dk-1983/Haier-ESP32-Modbus/bench/README_RU.md

[English](README.md) | [Русский](README_RU.md)

# Haier hOn: Arduino Nano bench simulator 0.1.1

Имитатор ответов кондиционера для проверки **обычной прошивки ESP32-S3** и двух оптических каналов на столе. Реальный кондиционер полностью отключён от стенда. Независимый тестовый инструмент, не заводская прошивка и не полная модель поведения Haier.

## Подключение

Подтверждённая плата: классическая **Nano ATmega328P, 5 В**. На ESP остаётся основная прошивка проекта, GPIO17 TX / GPIO18 RX, 9600 8N1, без инверсии.

На Nano выбран SoftwareSerial: **D10 RX, D11 TX, 9600 8N1**. Аппаратный UART D0/D1 оставлен для USB-диагностики 115200; это исключает соединение выходов USB-UART адаптера и оптопары на RX0. На стороне ESP испытывается именно аппаратный UART полной прошивки, а не отдельный loopback-тест.

Используем два независимых канала из [схемы](../docs/PC817-UART-BENCH_RU.md), PC817 или проверенные по распиновке NEC PS2561-1:

| Соединение | На стенде |
|---|---|
| U1 анод, вывод 1 | +5 В Nano через 680 Ом |
| U1 катод, вывод 2 | Nano **D11 TX** |
| U1 коллектор, вывод 4 | ESP **GPIO18 RX**, подтяжка 2,2 кОм к **3,3 В ESP** |
| U1 эмиттер, вывод 3 | GND ESP |
| U2 анод, вывод 1 | +3,3 В ESP через 390 Ом |
| U2 катод, вывод 2 | ESP **GPIO17 TX** |
| U2 коллектор, вывод 4 | Nano **D10 RX**, подтяжка 4,7 кОм к **5 В Nano** |
| U2 эмиттер, вывод 3 | GND Nano |

Оба канала неинвертирующие. Никаких прямых перемычек TX-RX в обход оптопар; старый делитель/стабилитрон не подключать параллельно выходу U1. Пины 5 В, 3,3 В и TX — разные электрические цепи.

Nano питается от USB, ESP — от своего подходящего источника/программатора. **Не питать ESP от выхода 3,3 В Nano.** Не соединять выходы разных источников питания друг с другом. Общая земля допустима; при общей земле/общем USB это не испытание гальванической изоляции. Соединения менять при снятом питании.

## Сборка и загрузка

Открыть `haier_simulator/haier_simulator.ino` в Arduino IDE. Выбрать Arduino Nano, ATmega328P. Для старого загрузчика — ATmega328P (Old Bootloader); тип загрузчика конкретной платы ещё не определён. Порт Nano определить отдельно, **не считать COM6 её портом по старым сообщениям**. Встроенная SoftwareSerial — единственная библиотека.

CLI (из корня проекта):

```powershell
arduino-cli compile --fqbn arduino:avr:nano:cpu=atmega328old --build-path work/nano-simulator bench/haier_simulator
```

Для нового загрузчика использовать `cpu=atmega328`. Это выбор скорости/загрузчика Nano; прошлые 2 Мбод относятся к S3, а не к Nano. Сборка проверена Arduino AVR core 1.8.6: 6928 байт flash, 721 байт статической RAM. 2026-09-20: v0.1.1 загружена в Nano ATmega328P, flash проверена чтением. На этом этапе обмен через оптопары ещё не прошёл: входящие кадры искажены. Более поздние результаты — в [HARDWARE.md](../docs/HARDWARE_RU.md).

## Что имитируется

- Версия 0x61/0x62 (идентификатор SIMULATR, объявлена поддержка CRC), ID 0x70/0x71.
- Опрос 0x4D01 и big-data 0x4DFE, ответ STATUS 0x02.
- Групповая запись 0x6001 из текущей основной прошивки, сохранение всех 10 управляющих байт в RAM.
- Подмножество одиночных записей 0x5Dxx: питание, температура, режим, вентилятор, жалюзи, display, quiet, boost, sleep и др.; неизвестные команды возвращают INVALID 0x03.
- Пустые аварии 0x73/0x74, управление связью 0xFC/0xFD, подтверждение 0xF7.
- Контрольная сумма, CRC-16/ARC, FF55 stuffing, восстановление после повреждения/обрыва пакета. Максимальный payload 64 байта; интервал между байтами >100 мс сбрасывает незаконченный кадр.

Размер STATUS соответствует локальной конфигурации: 2 байта subtype + 10 управления + 18 датчиков + 4 дополнительных байта датчиков. Big-data добавляет 14 байт. Заголовок статуса 0 байт. Смена этих настроек в ESP требует синхронного изменения имитатора.

Начальное состояние: выключен, выбран COOL, уставка 24 °C, fan AUTO, display включён. Фиктивные показания: комната **23,5 °C**, влажность 45%, улица 20 °C. Команды изменяют состояние сразу, оно сохраняется до перезагрузки Nano. Тепловая динамика, компрессор, задержки циклов, аварии и автономные изменения режимов не моделируются. Нулевые big-data мощности/приводов — заглушки.

**Веб-интерфейс/MQTT ESP покажет эти значения как обычные данные устройства.** Для первого теста использовать веб-интерфейс и отключить MQTT/Modbus через штатные настройки ESP, если к этому экземпляру привязаны домашние автоматизации. Отдельное MQTT-имя/топик нужны, если позднее подключаем стенд к HA. Прошивка ESP сама не маркирует показания как синтетические.

## Проверка на столе

1. Открыть USB-журнал Nano, 115200. Открытие монитора может перезапустить Nano и сбросить её состояние.
2. Запустить обычную ESP, дождаться инициализации hOn. В журнале Nano должны появиться 0x61, 0x70, 0x01, 0x73; на ESP — First HVAC status received / available, растущий status_frames и 23,5 °C.
3. Из веб-интерфейса ESP проверить ON, OFF, уставку, режим, fan, quiet/display и жалюзи. `commands` Nano растёт, последующие опросы возвращают последнее состояние. GPIO13 LED Nano мигает при валидном входящем пакете.
4. Оставить минимум на 10 минут. Ожидаем рост `good` и `sent`, отсутствие роста `bad`, `partial_timeout`, `overflow` и отсутствие таймаутов ESP при обычном обмене. Это проверка стенда, не гарантия поведения реального Haier.
5. В USB-журнал отправить `m`: ответы прекратятся, ESP должна увидеть таймауты. `r` возвращает ответы; проверить восстановление связи (после длинной паузы ESP может повторить инициализацию).
6. Команда `c` однократно изменяет байт следующего ответа без пересчёта суммы/CRC. ESP должна отвергнуть кадр и восстановить обмен на следующем запросе. `s` печатает статистику немедленно.

`bytes=0` — Nano не получает байты от ESP (проверять U2/TX17/D10). `bytes` растёт, `good=0` — неверные уровни, скорость, инверсия или повреждение кадров. `good` и `sent` растут, ESP не видит ответов — проверять U1/D11/RX18. SoftwareSerial также может терять данные; для этого есть счётчик `overflow`. Это направления диагностики, не однозначный диагноз по одному счётчику.

Успех доказывает работу полной ESP-прошивки и адаптера с 5-вольтовыми выводами Nano при 9600 бод. Он **не доказывает**, что выход TX реального Haier способен поглощать тот же ток LED или имеет такие же пороги/фронты.

Версия 0.1.1 печатает `WIRE RX` после паузы 30 мс: до 96 сырых байтов для диагностики искажений перед разбором пакета. Это фактически принятые SoftwareSerial байты, а не измерение аналоговой формы сигнала.

## Автоматические проверки

`python tools/test_hon_simulator.py` использует HaierProtocol 0.9.31 из локальной сборки ESP как независимый эталон кодирования/разбора. Проверяет 2000 комбинаций payload/CRC, FF55, повреждение суммы/CRC, усечённые/последовательные кадры, восстановление, handshake и сохранение команд. Это host-тесты, не электрические измерения.

Код имитатора написан отдельно, MIT. Источники формата для совместимости: `components/haier/hon_packet.h`, `hon_climate.cpp` и HaierProtocol 0.9.31; исходники сторонних библиотек в этот скетч не копируются. Arduino AVR core и SoftwareSerial сохраняют собственные лицензии.
