dk-1983/Haier-ESP32-Modbus/docs/SCHEMATIC_RU.md

[English](SCHEMATIC.md) | [Русский](SCHEMATIC_RU.md)

## Обновлённая электрическая схема — rev1.0

Электрическая схема rev1.0

[Открыть / скачать SVG](assets/haier-schematic-rev1.0.svg) · [PNG](assets/haier-schematic-rev1.0.png)

Актуальная электрическая схема будущей платы v1.0. Включены оба входных делителя RX 10/20 кОм, подтяжка GPIO21 к земле 10 кОм, терминатор R7 (120 Ом) с исходно разомкнутой перемычкой JP1, клеммник J2 (RS-485 A/B), параллельные площадки TP7/TP8, площадки UART0 для программатора и кнопки EN/BOOT. C1 — 220 мкФ / 10 В, C3 — 100 мкФ / 10 В, оба танталовые в корпусе C (6032-28). C2/C4/C5/C6 — 0,1 мкФ / 50 В. J1 — JST SM04B-GHS-TB: контакты 1–4 — +5 В, GND, TX Haier, RX Haier.

Одинаковые метки цепей означают электрическое соединение. H_TX = GPIO17 → RX Haier; H_RX = TX Haier через делитель → GPIO18. MB_TX = GPIO15 → DI MAX485; MB_RX = RO MAX485 через делитель → GPIO16; DIR = GPIO21 → DE и /RE. TP6 (+3V3) предназначена для измерения напряжения, а не отдельной подачи питания.

При сборке только для MQTT можно не устанавливать узел RS-485: U3, R4–R7, C6, JP1, J2 и TP7/TP8. Питание и делитель UART Haier сохраняются.

Проверка KiCad ERC завершилась без ошибок и предупреждений. Плата v1.0 **ещё не собрана и не проверена аппаратно**. Разводка PCB, производственные файлы и Gerber не публикуются до проверки автором. Конкретный корпус J2 ещё подбирается; электрические соединения уже определены на схеме. Ниже сохранены прежняя схема стенда и её пояснения для справки.

Актуальная оптическая схема с подтяжками **1 кОм / 2 кОм**, проверкой выводов и результатами 9600/19200: [Оптический UART](OPTICAL-UART_RU.md). Значения 2,2/4,7 кОм ниже, если указаны, относятся к первоначальному стенду.

# Электрическая схема макета

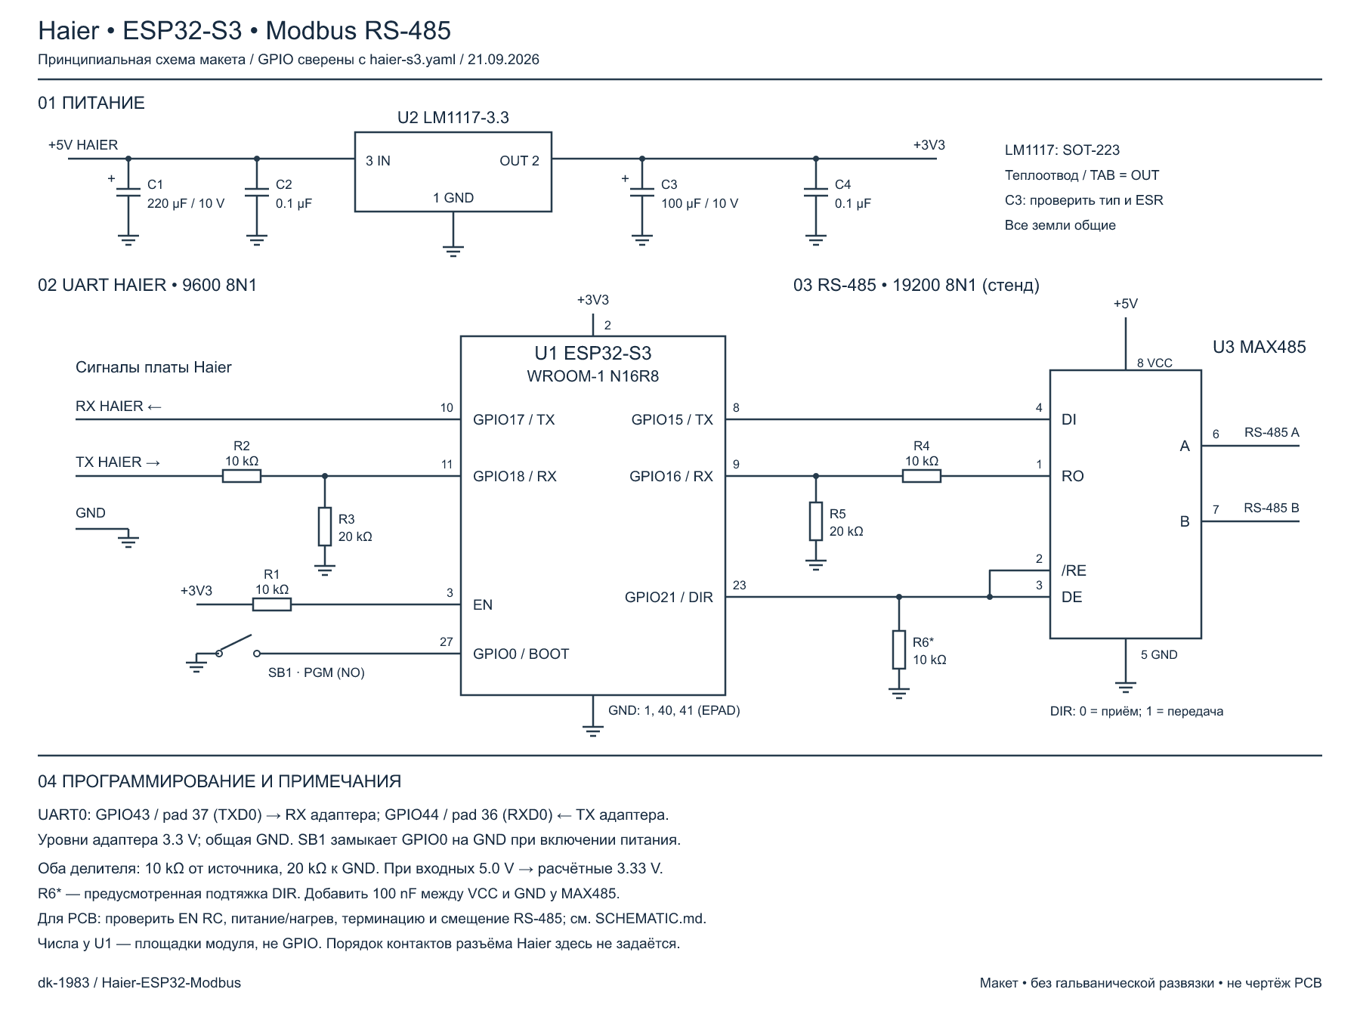
[picture p7: docs/assets/haier-s3-schematic.png]
Схема Haier ESP32-S3 и MAX485


[Векторная схема SVG](assets/haier-s3-schematic.svg) · [PNG](assets/haier-s3-schematic.png)

Перечерчено по рисунку автора с уточнениями от 21.09.2026. Это схема проверенного макета с документированными дополнениями, не готовая PCB. Обозначения выводов сверены с прошивкой `haier-s3.yaml` и документацией изготовителей. Реальную маркировку припаянных деталей и ESR конденсаторов по рисунку установить нельзя.

## Сборка для MQTT без RS-485

**Если нужен Home Assistant через MQTT, часть схемы «03 RS-485» можно не собирать.** Не устанавливайте **U3 (MAX485), R4, R5, R6**, локальный конденсатор питания MAX485 и разъём A/B. Соединения этого узла с GPIO15, GPIO16 и GPIO21 не нужны.

Остаются ESP32-S3, питание, цепи EN/BOOT и UART Haier: **GPIO17 → RX Haier**, **TX Haier → делитель R2/R3 → GPIO18**, общая земля. **R2 и R3 обязательно сохраняются** — это согласование входа от кондиционера, а не часть RS-485.

Используется та же основная прошивка `haier-s3.yaml`; отдельная сборка не нужна. На `/modbus` оставьте **RTU выключенным**, на `/mqtt` включите MQTT и Discovery. Веб-пульт и OTA остаются доступны. **Modbus TCP по Wi-Fi также работает без MAX485**, если позже понадобится подключение через Modbus Devices.

## Проверка выводов

| Цепь | GPIO ESP32-S3 | Площадка WROOM-1 | Другой конец |
|---|---|---|---|
| Haier TX контроллера | 17 | 10 | RX Haier, напрямую |
| Haier RX контроллера | 18 | 11 | TX Haier через R2/R3 |
| RS-485 TX контроллера | 15 | 8 | MAX485 DI, вывод 4 |
| RS-485 RX контроллера | 16 | 9 | MAX485 RO, вывод 1, через R4/R5 |
| Направление RS-485 | 21 | 23 | MAX485 DE (3) и /RE (2) вместе |
| UART0 TX | 43 | 37 | RX программатора, логика 3,3 В |
| UART0 RX | 44 | 36 | TX программатора, логика 3,3 В |
| BOOT | 0 | 27 | SB1 на GND при включении питания |
| EN | — | 3 | R1 10 кОм к 3,3 В |
| Питание | — | 2 | 3,3 В |
| Земля | — | 1, 40, 41 | Общая GND, включая центральную площадку |

MAX485 DIP/SO: **1 RO, 2 /RE, 3 DE, 4 DI, 5 GND, 6 A, 7 B, 8 VCC**. Обведённый на исходном рисунке номер 23 — площадка GPIO21, а не GPIO23. RO подключается к GPIO16; GPIO18 занят отдельным UART Haier. Все номера на символах — номера выводов компонентов, а не порядок контактов внешнего разъёма Haier.

## Номиналы и питание

| Деталь | Значение | Основание |
|---|---|---|
| U1 | ESP32-S3-WROOM-1 N16R8 | Целевой модуль проекта |
| U2 | LM1117-3.3, фиксированные 3,3 В | Обозначение на рисунке; корпус/маркировку сверить перед PCB |
| U3 | MAX485, питание 5 В | Проверенный интерфейс |
| R1 | 10 кОм | Подтяжка EN |
| R2, R4 | 10 кОм | От источника сигнала к RX |
| R3, R5 | 20 кОм | От RX к GND |
| R6 | 10 кОм | Подтяжка DIR к GND из документации проекта; на фото отсутствует |
| C1 | 220 мкФ / 10 В | По рисунку |
| C2, C4 | 0,1 мкФ | C4 уточнён автором |
| C3 | 100 мкФ / 10 В | По рисунку; тип и ESR требуют проверки |
| SB1 | Кнопка без фиксации, нормально разомкнутая | BOOT / PGM |

У LM1117-3.3 в SOT-223: **1 GND, 2 OUT, 3 IN; TAB также OUT**. Теплоотвод нельзя соединять с землёй. Для других корпусов нужна их распиновка. По TI для выходного конденсатора указаны минимум 10 мкФ (тантал) и ESR 0,3–22 Ом. Поэтому 100 мкФ по величине достаточно, но без типа/серии конденсатора нельзя подтвердить устойчивость. C4 100 нФ не заменяет C3. Другой изготовитель 1117 может задавать другие требования.

Питание MAX485 по даташиту — 4,75–5,25 В. Его DI, DE и /RE распознают высокий уровень от 2 В: дополнительный каскад повышения 3,3 → 5 В для этих входов не требуется. RO относится к 5-вольтовой стороне, поэтому прямой провод на ESP заменён делителем.

Для обоих делителей `V_RX = V_source × 20 / (10 + 20)`: при 5,0 В получается 3,33 В. Это номинальный расчёт, не стабилизатор. Проверяют максимальный уровень и допуски, а также минимальный HIGH на принимающем GPIO. В частности, гарантированный MAX485 VOH при указанной в даташите нагрузке — 3,5 В; после делителя это 2,33 В. Стенд с лёгкой нагрузкой работал, но это не доказывает гарантированный запас по всем экземплярам и температурам. Для серийной платы следует рассмотреть 3,3-вольтовый трансивер либо буфер с 5-вольтным допустимым входом.

## Что дополнено и что остаётся для PCB

- На RO MAX485 восстановлен пропущенный в рисунке делитель R4/R5, подтверждённый автором и стендом.
- R6 показан отдельно как предусмотренная аппаратная подтяжка направления; наличие на макете не установлено по фото.
- У MAX485 нужен локальный конденсатор 100 нФ между 8 и 5, рядом с корпусом. Он указан в примечании, а не выдан за установленную деталь.
- Для EN следует предусмотреть задержку запуска согласно Espressif (типовой RC 10 кОм / 1 мкФ); на исходном рисунке показан только R1. Разводку питания и нагрев LM1117 проверить при пиковом потреблении Wi-Fi. При 0,5 А и входных 5 В расчётное рассеяние — 0,85 Вт.
- Терминация и смещение RS-485 зависят от линии и уже установленных резисторов шлюза; на этой схеме они не заданы.
- Возврат питания Haier обозначен GND, не «−5 В». Схема имеет общую землю и не обеспечивает гальваническую развязку.

## Первичные источники

- [Espressif ESP32-S3-WROOM-1/1U — распиновка модуля](https://documentation.espressif.com/esp32-s3-wroom-1_wroom-1u_datasheet_en.pdf).
- [Espressif — питание и EN](https://docs.espressif.com/projects/esp-hardware-design-guidelines/en/latest/esp32s3/schematic-checklist.html).
- [Analog Devices / Maxim — MAX485, выводы и электрические характеристики](https://www.analog.com/media/en/technical-documentation/data-sheets/MAX1487-MAX491.pdf).
- [Texas Instruments — LM1117, выводы и выходные конденсаторы](https://www.ti.com/lit/ds/symlink/lm1117.pdf).

Схема нарисована в SVG; PNG — её растровая копия. Генератор: `tools/draw_schematic.py` (для PNG требуется `resvg-py`).
