dk-1983/Haier-ESP32-Modbus/docs/HARDWARE_RU.md

[English](HARDWARE.md) | [Русский](HARDWARE_RU.md)

Актуальная оптическая схема с подтяжками **1 кОм / 2 кОм**, проверкой выводов и результатами 9600/19200: [Оптический UART](OPTICAL-UART_RU.md). Значения 2,2/4,7 кОм ниже, если указаны, относятся к первоначальному стенду.

# Стенд ESP32-S3-WROOM-1 N16R8

Это конфигурация нового модуля ESP32-S3, а не заводского одноядерного ESP32-for-Haier. Нужны питание3.3V, общая земля, цепь EN/BOOT и UART-программатор с логикой3.3V. Модуль не имеет входа5V; схему питания сверяйте с [Espressif](https://docs.espressif.com/projects/esp-hardware-design-guidelines/en/latest/esp32s3/schematic-checklist.html).

| Назначение | Вывод ESP32-S3 | Подключение |
|---|---|---|
| UART0 TX | GPIO43 / TXD0 | RX программатора ESP Link |
| UART0 RX | GPIO44 / RXD0 | TX программатора ESP Link |
| hOn TX | GPIO17 | RX платы кондиционера |
| hOn RX | GPIO18 | TX платы кондиционера |
| RS485 TX | GPIO15 | DI трансивера |
| RS485 RX | GPIO16 | RO трансивера |
| RS485 direction | GPIO21 | DE и /RE вместе, подтяжка10k кGND |
| GND | GND | Общая сигнальная земля по схеме питания/изоляции |

Выводы заданы substitutions в haier-s3.yaml. UART0 зарезервирован под прошивку/логи, остальные два аппаратных UART выделяются ESPHome двум UART-компонентам. GPIO35..37 у N16R8 заняты PSRAM и не используются. GPIO0/45/46 не используются для шины.

Трансивер должен иметь совместимые3.3V уровни (например3.3V RS485-трансивер); голый5V MAX485 нельзя напрямую подключать выходомRO к ESP32. MAX485ESA USB-адаптер может служить клиентской стороной RS485 без переделки. Терминация и смещение шины выбираются для фактической линии; это не законченный проект промышленной защиты/изоляции.

На DE предусмотрите аппаратную подтяжку кGND, чтобы передатчик молчал при reset/boot. ESPHome flow_control_pin использует штатный UART RS485 half-duplex driver. Отключённый RTU не передаёт ответы. Питание модуля и изоляцию относительно силовой платы проверяют до подключения USB/компьютера.

## Электрическая схема

[Схема и проверка номиналов/пинов](SCHEMATIC_RU.md) · [SVG](assets/haier-s3-schematic.svg) · [PNG](assets/haier-s3-schematic.png).

## Проверенное подключение

Haier UART: 9600 8N1, TX GPIO17 → RX Haier; TX Haier → согласование уровня → GPIO18. Инверсии и внутренние подтяжки не используются. Выход 5 В нельзя соединять с GPIO ESP32 напрямую. Резистивный делитель включается только в направлении 5 В → 3,3 В:

```text
TX источника ── Rверх ──┬── RX ESP32
                       Rниз
                        │
                       GND
```

Uвыход = Uвход × Rниз / (Rверх + Rниз). Номиналы выбирают по фактическому максимальному уровню источника, допускам и форме импульсов. Проверка выполняется относительно общей земли, до подключения GPIO. На стенде MAX485 RO проверен с Rверх=10 кОм и Rниз=20 кОм; это зафиксированный опыт, не универсальный номинал для любого питания.

MAX485: DI (4) ← GPIO15; RO (1) → делитель → GPIO16; DE (3) и /RE (2) вместе ← GPIO21; подтяжка GPIO21 10 кОм к GND. Питание MAX485 — 5 В. Прямое управление входами DI/DE допустимо лишь при соблюдении порогов конкретного трансивера; выход RO согласуется отдельно. Физический канал проверен на 19200 8N1 через [4VRS Gateway для Moxa](https://github.com/dk-1983/moxa-4vrs-gateway) на UC-7420-LX Plus в режиме Modbus TCP → RTU и [Modbus Devices для Home Assistant](https://github.com/dk-1983/Modbus_Devices) с профилем YCJ-A002. Подробности настройки Moxa: [руководство Gateway](https://github.com/dk-1983/moxa-4vrs-gateway/blob/main/docs/user-guide.md).

Две обычные транзисторные оптопары были испытаны на UART 9600. Обмен работал, но фронты затянуты. На передаче MAX485 при 19200 короткие импульсы искажались; прямое управление DI восстановило обмен. Для изолированного варианта выбирают оптопары/цифровой изолятор с подходящими временными характеристиками. Общая земля или общее неизолированное питание отменяют полную гальваническую развязку.

## Стенд до подключения кондиционера

В `bench/` находится эмулятор Haier для Arduino Nano ATmega328P (5 В), SoftwareSerial RX D10 / TX D11. Сначала проверяют GPIO и петлю TX/RX на 3,3 В, затем согласование уровней и обмен с эмулятором. Контроль осциллографом выполняют на принимающем выводе, включая короткие импульсы, а не только на TX источника.

Подтверждены 16 МБ Flash, 8 МБ PSRAM, работа UART без подтяжек и инверсии, локальное управление и OTA. Диагностические `gpio17-test.yaml` и `uart-loopback-test.yaml` не являются рабочей прошивкой кондиционера. Итоги: [VALIDATION.md](VALIDATION_RU.md).

Это проверенный макет интерфейсов, а не законченный проект печатной платы. Стабилизатор, защита питания, корпус, разъёмы, развязка и защита RS-485 проектируются отдельно. Номера GPIO не являются номерами контактов разъёма кондиционера.

## Обозначение разъёма для заказа

В [README исходного проекта haier-esphome](https://github.com/paveldn/haier-esphome#haier-climate) указан **JST SM04B-GHS-TB** в контексте Wi-Fi-модуля ESP32-for-Haier. Это разъём для монтажа на плату; нельзя автоматически считать его обозначением разъёма на материнской плате внутреннего блока с наших фотографий.

Ответная кабельная часть для этой серии GH: корпус **GHR-04V-S** и четыре обжимных контакта **SSHL-002T-P0.2**. Шаг GH — **1,25 мм**; см. [каталог JST](https://www.jst-mfg.com/product/index.php?lang=2&series=105) и [даташит изготовителя](https://www.jst-mfg.com/product/pdf/eng/eGH.pdf). Для заказа разъёма именно к нашей материнской плате ещё нужно подтвердить шаг контактов и форму сопряжения/ключа на оригинале. Точный артикул ответной части пока не подтверждён; рендер не служит образцом для измерений.
