dk-1983/Haier-ESP32-Modbus/docs/PC817-UART-BENCH_RU.md

[English](PC817-UART-BENCH.md) | [Русский](PC817-UART-BENCH_RU.md)

Актуальная оптическая схема с подтяжками **1 кОм / 2 кОм**, проверкой выводов и результатами 9600/19200: [Оптический UART](OPTICAL-UART_RU.md). Значения 2,2/4,7 кОм ниже, если указаны, относятся к первоначальному стенду.

# Два канала PC817 для UART Haier — стендовый вариант

Первоначальный статус: предложенная схема, ещё не собрана и не проверена (последующее обновление по стенду ниже). 9600 8N1. Питание ESP от Haier через обычный стабилизатор означает общую землю: это оптическая передача сигналов и согласование уровней, НЕ полная гальваническая развязка плат. Перегрузка GPIO старой ESP8266 не доказана; 5 В на её GPIO не считаются допустимыми лишь потому, что обмен работал.

PC817: 1 анод, 2 катод, 3 эмиттер, 4 коллектор. Нумерацию сверить с корпусом конкретного производителя.

## U1: TX Haier -> RX ESP

```
+5V Haier -- R1 680 Ом -- U1 pin1 (A)
TX Haier --------------- U1 pin2 (K)

+3.3V ESP -- R2 2.2 кОм --+-- RX ESP
                          |
                        U1 pin4 (C)
GND ESP ---------------- U1 pin3 (E)
```

## U2: TX ESP -> RX Haier

```
+3.3V ESP -- R3 390 Ом -- U2 pin1 (A)
TX ESP ----------------- U2 pin2 (K)

+5V Haier -- R4 4.7 кОм --+-- RX Haier
                          |
                        U2 pin4 (C)
GND Haier -------------- U2 pin3 (E)
```

При LOW передатчик поглощает ток LED, оптопара тянет RX вниз. При HIGH LED выключен, RX поднимается собственной подтяжкой. Оба канала НЕ инвертируют: прошивка без инверсии. ESP GPIO никогда не соединяется с выходной 5-вольтовой точкой U2.

Начальные номиналы для стенда: ток LED около5 мА при LOW (зависит от VF/VOL). Нагрузка коллектора U1 около1.5 мА, U2 около1 мА без учёта внутренней подтяжки Haier. Выход TX Haier должен уметь поглощать этот ток; его допустимая нагрузка и внутренняя схема ещё не установлены. Номиналы требуют проверки LOW/HIGH и формы импульсов, особенно при большом CTR и насыщении PC817. Старый делитель/стабилитрон не оставлять параллельно выходу оптопары.

## Стенд перед Haier

Обе линии Haier отключены. Каждый PC817 проверить по отдельности существующим UART loopback-тестом: GPIO17 управляет его LED от3.3В через390Ом; коллектор идёт на GPIO18 с подтяжкой2.2кОм к3.3В, эмиттер на GND. Прямая перемычка17-18 убрана. Так проверяются обе оптопары с одинаковыми3.3В условиями; этот тест ещё не проверяет TX Haier и рабочие5В условия U1/U2.

Не замыкать выход двухканального адаптера на его вход для сквозного теста без расчёта нагрузки: коллектор U2 тогда должен поглощать ток LED U1 плюс ток своей подтяжки. Это больше нагрузки обычного RX.

После отдельных PASS проверить каналы при рабочих напряжениях с подходящим5В драйвером/измерением; затем Haier. Измерять фронты предпочтительно анализатором/осциллографом. PC817 не гарантирован для произвольной схемы UART9600: паспортные времена4/3мкс тип.,18мкс макс. заданы при VCE2В, IC2мА, RL100Ом, а не для наших подтяжек. Наличие PASS локального теста не гарантирует обмен Haier.

S3: TX GPIO17, RX GPIO18. ESP8266 текущего проекта: TX GPIO5(D1), RX GPIO4(D2).

Источник: Sharp PC817XxNSZ1B, pinout/CTR/timing: https://global.sharp/products/device/lineup/data/pdf/datasheet/PC817XxNSZ1B_e.pdf

## Стенд с Arduino вместо кондиционера

Для проверки обоих каналов при 5/3,3 В с основной прошивкой ESP подготовлен [имитатор hOn на Nano ATmega328P](../bench/README_RU.md). Nano D11 заменяет TX Haier, D10 — RX Haier. Это не сквозная петля оптопар: каждую LED-цепь питает самостоятельный выход микроконтроллера. Совместимый вариант оптопары — NEC PS2561-1 после сверки распиновки. Обмен на этом стенде подтверждён. Затянутые фронты ограничивают применимость оптопар; результаты и проверенные альтернативы приведены в [HARDWARE.md](HARDWARE_RU.md).
