dk-1983/Haier-ESP32-Modbus/docs/IMPLEMENTATION_RU.md

[English](IMPLEMENTATION.md) | [Русский](IMPLEMENTATION_RU.md)

# Устройство программы

`haier-s3.yaml` задаёт два аппаратных UART, PSRAM и локальные компоненты. UART0 остаётся для загрузчика/логов.

`fourvrs_portal` владеет Wi-Fi, настройкой сети, WebServer и ArduinoOTA. Отдельный компонент ESPHome wifi не включается: два владельца радио конфликтовали бы. Python-конфигурация явно включает Arduino-библиотеки, SoftAP/DHCP и зависимости OTA.

`modbus_core.h` разбирает ограниченные по размеру PDU/ADU без динамического выделения памяти. `register_model.h` проверяет весь пакет изменений до вызова аппаратного кода. `modbus_bridge.cpp` обслуживает RTU, два TCP-клиента, настройки и привязку регистров к телеметрии.

Все интерфейсы используют общий флаг ожидающей команды. Положительный Modbus-ответ подтверждает приём, два последующих совпадающих status-пакета подтверждают состояние. Незавершённые команды завершаются по тайм-ауту через 30 секунд. Чтение использует исходные status-поля, а не оптимистичные свойства ClimateCall.

Компонент Haier сохранён из ESPHome. Локальные изменения: запрет автоматических действий в MONITOR_ONLY и применение валидированных полей Modbus после существующего кодировщика SET_GROUP_PARAMETERS. `bridge_control.h` сохраняет независимость режима и питания, а также обеспечивает запись нескольких полей независимо от предыдущего режима. Протокол hOn заново не реализован.

Формат status в этой конфигурации: 2 байта подкоманды, 10 байт control, 18 байт sensors и 4 дополнительных байта; копирование ограничено размером структуры sensors; status_message_header_size=0. Для другой модели формат следует подтвердить до использования.
