dk-1983/Haier-ESP32-Modbus/docs/SYSTEM_RU.md

[English](SYSTEM.md) | [Русский](SYSTEM_RU.md)

# Вся система: Haier → ESP32-S3 → Home Assistant

Три проекта образуют общий путь управления: **Haier-ESP32-Modbus** общается с кондиционером, **Moxa / 4VRS Gateway** передаёт Modbus между RS-485 и сетью, **Modbus Devices** добавляет оборудование в Home Assistant. Для каждой части доступны исходники, настройка и результаты проверок.

## Что подготовить

| Часть | Для чего нужна | Где взять описание |
|---|---|---|
| Совместимый Haier с hOn UART | Управляемый кондиционер; проверен AS25HSL1HRA-W | [Результаты проверки](VALIDATION_RU.md) |
| ESP32-S3-WROOM-1 N16R8, питание и согласование уровней UART | Контроллер с этой прошивкой | [Подключение GPIO и уровней](HARDWARE_RU.md), [сборка прошивки](../README_RU.md#сборка) |
| Home Assistant и Modbus Devices | Управление питанием, режимом, температурой и вентилятором | [Проект Modbus Devices](https://github.com/dk-1983/Modbus_Devices) |
| Трансивер RS-485 и Moxa с 4VRS Gateway | Вариант подключения через последовательную линию | [Подключение MAX485](HARDWARE_RU.md), [проект Gateway](https://github.com/dk-1983/moxa-4vrs-gateway) |

Moxa и трансивер нужны для варианта RS-485. При прямом Modbus TCP по Wi-Fi достаточно ESP и Home Assistant с Modbus Devices. Проект предоставляет программные компоненты и проверенное подключение макета; законченная печатная плата, корпус и схема промышленной защиты пока не выпускаются.

## 1. Запустить контроллер Haier

Соберите основную прошивку `haier-s3.yaml` со своими паролями по [README](../README_RU.md#сборка). Подключите UART и питание по [HARDWARE.md](HARDWARE_RU.md). Настройте Wi-Fi через точку первоначальной настройки, затем откройте `/control` по полученному адресу ESP.

До настройки остальных частей убедитесь, что контроллер получает свежую температуру и состояние кондиционера. Одна тестовая команда должна завершиться подтверждением Haier; после неё верните исходную настройку. [API и правила подтверждения](API_RU.md).

## 2. Выбрать путь связи

| Путь | Настройки ESP | Настройки Moxa | Транспорт Modbus Devices |
|---|---|---|---|
| ESP → Wi-Fi → Home Assistant | TCP включён, порт 502 | Не используется | Modbus TCP/IP |
| ESP → RS-485 → Moxa → Home Assistant | RTU включён; для описанного стенда 19200 8N1, адрес 1 | Modbus TCP → RTU, последовательные параметры совпадают с ESP | Modbus TCP/IP; адрес и сетевой порт Moxa |
| ESP → RS-485 → Moxa RAW → Home Assistant | RTU включён, параметры совпадают с Moxa | RAW TCP | Modbus RTU over TCP; адрес и сетевой порт Moxa |

Настройки ESP находятся на `/modbus`. RTU и TCP включаются независимо. Для Moxa используйте [руководство 4VRS Gateway](https://github.com/dk-1983/moxa-4vrs-gateway/blob/main/docs/user-guide.md). Modbus TCP использует MBAP, RAW TCP переносит RTU с CRC; транспорт клиента должен соответствовать выбранному режиму шлюза.

В наших испытаниях физической линии использовалась Moxa UC-7420-LX Plus с 4VRS Gateway в режиме Modbus TCP → RTU. Подробная [карта регистров и варианты транспорта](REGISTERS_RU.md#home-assistant-и-moxa).

## 3. Подключить Modbus Devices

Установите или обновите [Modbus Devices](https://github.com/dk-1983/Modbus_Devices/blob/main/README_RU.md) до **1.3.0 или новее** через HACS и перезапустите Home Assistant. При добавлении нового хаба выберите производителя **4VRS**, модель **Haier-ESP32**. Укажите выбранный транспорт, адрес ESP или Moxa, соответствующий сетевой порт и Unit ID.

Это готовый профиль нашей разработки: климат, качание и фиксированные положения жалюзи, пресеты, тихий режим, дисплей и диагностика связи/команд. Ручное описание регистров не требуется. Профиль подтверждает команды через контроллер и обратное чтение. Отдельный профиль **Haier YCJ-A002** сохраняется для заводского адаптера; для расширенных функций ESP выбирайте **4VRS Haier-ESP32**.

Для панели можно воспользоваться генератором карточки в Modbus Devices. [Краткая инструкция в README](../README_RU.md#готовая-интеграция-с-home-assistant). Полная аппаратная проверка расширенного профиля, согласно описанию Modbus Devices, запланирована с производственной платой; результаты уже выполненных проверок прошивки приведены в [VALIDATION.md](VALIDATION_RU.md).

## 4. Проверить всю цепочку

1. Сверьте температуру, уставку и питание в Home Assistant с локальным пультом ESP.
2. Измените одну настройку из Home Assistant и дождитесь фактического обратного состояния. Положительный ответ Modbus означает принятие команды; `Input 7 = 2` означает подтверждение двумя пакетами Haier.
3. Для питания используется **Coil 0: 0 = выключить, 1 = включить**. Выбирайте подходящий момент для такой проверки; не переключайте компрессор часто.
4. Верните исходные настройки и проверьте их по свежему состоянию.

Если ответа нет, проверяйте цепочку по порядку: свежесть Haier на ESP → включённый транспорт ESP → последовательные параметры и режим Moxa → транспорт и адрес клиента. [Системы и результаты выполненных проверок](VALIDATION_RU.md#системы-использованные-в-проверках).

## Дополнительный путь MQTT

Эта же прошивка поддерживает MQTT и Home Assistant Discovery через внешний брокер. Это отдельный вариант подключения к Home Assistant; его настройка описана в [MQTT.md](MQTT_RU.md). В отчёте отдельно указаны проверка MQTT-команд и границы проверки интерфейса Home Assistant.
