dk-1983/Haier-ESP32-Modbus/THIRD_PARTY_NOTICES_RU.md

[English](THIRD_PARTY_NOTICES.md) | [Русский](THIRD_PARTY_NOTICES_RU.md)

# Лицензии и происхождение

Независимый проект совместимости. Названия Haier, ESPHome, Espressif и продуктов обозначают совместимое оборудование/ПО; принадлежность к этим компаниям или их одобрение не заявляются.

| Часть | Источник | Лицензия |
|---|---|---|
| Новое ядро Modbus, планировщик регистров, транспорт, настройка и документация | Этот проект | MIT, см. LICENSE |
| Wi-Fi портал и интерфейс настройки | Адаптация 4VRS rack_bootstrap | MIT, см. LICENSE-4VRS |
| `components/haier/*.cpp`, `*.h` и подкаталоги (кроме независимо написанного MIT `bridge_control.h`) | Компонент Haier ESPHome2026.6.5, автор Pavlo Dudnytskyi; с локальными изменениями | GPLv3, см. LICENSE-ESPHome |
| Python в `components/haier` | ESPHome2026.6.5 | MIT-часть LICENSE-ESPHome |
| Среда ESPHome, подключаемая при сборке | ESPHome2026.6.5 | GPLv3 для C++; MIT для Python/инструментов |
| HaierProtocol | pavlodn/HaierProtocol0.9.31 | MIT, см. LICENSE-HaierProtocol |
| Arduino-ESP32 / ESP-IDF | Загружаемые зависимости | Их LGPL/Apache и лицензии компонентов; сохраняйте исходные уведомления |

MIT применяется к независимо созданным файлам и не меняет лицензию ESPHome. Распространение объединённой прошивки должно соответствовать GPLv3, включая предоставление соответствующих исходников, изменений и сведений о сборке. Лицензии зависимостей сохраняются. См. https://github.com/esphome/esphome и https://github.com/paveldn/HaierProtocol.

Локальные изменения Haier: защита действий MONITOR_ONLY из PoC; валидированные переопределения полей в конце существующего кодировщика групповых команд для атомарных Modbus-записей, независимости питания/режима и блокировки пульта. Изменения GPL-файлов остаются GPLv3.

Числовые определения YCJ-A002 используются для совместимости. Оригинальные руководства доступны у указанных издателей; репозиторий не распространяет их PDF или прошивки Haier. Совместимость регистров не означает одинаковое поведение во всех недокументированных случаях.

ESP-MQTT — официальный клиент Espressif из ESP-IDF 5.5.4, Apache-2.0; см. LICENSE-ESP-MQTT и https://github.com/espressif/esp-mqtt. Адаптеры MQTT и тесты этого проекта — MIT.

Служба управления и обновлений также использует адаптированные проверки JSON, TLS, подписанного манифеста и OTA из 4VRS-Display по LICENSE-4VRS. У проекта отдельный ключ подписи релизов.

**Основа проекта:** интеграция с протоколом Haier основана на [paveldn/haier-esphome](https://github.com/paveldn/haier-esphome), автор — Pavlo Dudnytskyi. В прошивке используется компонент Haier из ESPHome 2026.6.5 с нашими изменениями и HaierProtocol 0.9.31. Поверх этой основы реализованы наше веб-управление, MQTT-шлюз и интерфейсы Modbus. См. [происхождение кода и лицензии](THIRD_PARTY_NOTICES_RU.md).
