dk-1983/Haier-ESP32-Modbus/docs/MQTT_RU.md

[English](MQTT.md) | [Русский](MQTT_RU.md)

# MQTT-клиент через Wi-Fi

Контроллер подключается к внешнему брокеру по MQTT 3.1.1 TCP (по умолчанию порт 1883). Встроенного брокера нет. Первая версия предназначена для доверенной локальной сети: TLS не включён. Home Assistant Discovery доступен с версии 0.6.0.

## Настройка

Открыть `/mqtt`, авторизоваться `admin` и паролем управления. Указать адрес брокера (IPv4 или DNS-имя без `mqtt://`), порт, пользователя/пароль и уникальный префикс топиков. Пустое имя пользователя означает подключение без имени. По умолчанию префикс совпадает с hostname устройства.

MQTT выключен по умолчанию и включается независимо от RTU/TCP. Настройки хранятся в NVS. Пустое поле нового пароля сохраняет старый; отдельная галочка удаляет пароль. GET `/mqtt/config` возвращает только `password_set`, а не пароль. Смена настройки выполняется в фоне; повторная запись во время её применения возвращает HTTP409.

## Топики

Ниже `BASE` — выбранный префикс.

| Топик | Направление | Содержимое |
|---|---|---|
| `BASE/state` | Контроллер → брокер | JSON как `/haier/status`, без `last_status_hex`, каждые 5 секунд при соединении |
| `BASE/availability` | Контроллер → брокер | `online` / `offline`, QoS1 retained; offline также Last Will |
| `BASE/result` | Контроллер → брокер | JSON: accepted / confirmed / timeout_unconfirmed / rejected |
| `BASE/set/<field>` | Брокер → контроллер | Одно точное значение из таблицы ниже, без JSON |

`availability` показывает связь контроллера с брокером. Для связи с кондиционером проверяйте `state.available` и `age_ms`. State и result публикуются без retain, QoS0: старое состояние не выдаётся новому подписчику как свежее. В обычном режиме период state — 5 секунд. Пока команда ожидает подтверждения, state приостановлен; после подтверждения или таймаута публикация возобновляется.

| field | Значения (регистр букв важен) |
|---|---|
| power | OFF, ON |
| target | Целое 16..30 |
| mode | COOL, HEAT, DRY, FAN_ONLY, AUTO |
| hvac_mode | OFF, COOL, HEAT, DRY, FAN_ONLY, AUTO |
| fan | LOW, MEDIUM, HIGH, AUTO |
| lock | UNLOCK, LOCK |
| swing | OFF, VERTICAL, HORIZONTAL, BOTH |
| preset | NONE, BOOST, SLEEP |
| quiet | OFF, ON |
| display | OFF, ON |
| vertical_position | HEALTH_UP, MAX_UP, HEALTH_DOWN, UP, CENTER, DOWN |
| horizontal_position | CENTER, MAX_LEFT, LEFT, RIGHT, MAX_RIGHT |

Каждая команда проходит через тот же валидатор и арбитр, что Modbus. Режим отдельно от питания: запись mode не включает выключенный кондиционер. Ограничения сочетаний функций описаны в REGISTERS.md. Пока команда не завершена, следующая запись любого интерфейса отклоняется как busy.

Ответ `accepted` означает принятие, а не выполнение. Для принятой MQTT-команды создаётся `request_id` вида `mqtt-N`; два последующих совпадающих status-пакета дают `confirmed`. Ожидание ограничено 30 секундами. У отклонённой команды публикуются field, error (коды как Modbus) и reason. После обрыва сети result может быть потерян; проверяйте фактический state, его request_id и command_state.

## Пример

```sh
mosquitto_sub -h BROKER -t 'BASE/state' -t 'BASE/result' -t 'BASE/availability'
mosquitto_pub -h BROKER -t 'BASE/set/target' -m '22' -q 0
```

Добавьте параметры аутентификации своего брокера при необходимости. Не используйте `-r` для команд. Контроллер подписывается с QoS0 и clean session; офлайн-команды не накапливаются. Retained-пакеты, доставленные при подписке, отклоняются; DUP-пакеты также не исполняются. MQTT3.1.1 не позволяет подписчику определить retain исходной публикации при обычной живой пересылке: все отправители должны соблюдать правило «команды без retain».

## Работа при сбоях

ESP-MQTT из закреплённого ESP-IDF выполняет сетевые операции в фоновых задачах. Главный цикл не вызывает connect/subscribe/publish/stop и продолжает обработку UART, веба и Modbus при недоступном брокере. Повторное подключение — примерно каждые 5 секунд; keepalive 30 секунд. На переподключении восстанавливаются подписка и публикация состояния.

Очереди ограничены: 8 входящих команд и 4 публикации; пакет команды до 95 байт и топик до 127 байт. Неисполненная команда в очереди старше 1 секунды отклоняется. При переполнении сообщения могут быть потеряны; в `/mqtt/config` есть счётчик dropped. Это управление состоянием кондиционера, не гарантированная очередь заданий.

При штатном отключении делается попытка опубликовать offline и дождаться подтверждения; при разрыве сети Last Will устанавливается брокером после обнаружения разрыва/keepalive. Уже принятая hOn-команда завершается независимо от MQTT.

## Проверка

На ESP32-S3 с реальным Haier выполнена серия из 41 команды: уставка, все скорости, блокировка, дисплей, Quiet, пресеты, качание и фиксированные положения, режимы при выключенном блоке, OFF/ON и HVAC COOL. Каждая команда получила confirmed после двух совпадающих hOn-пакетов. Retained-команда при подключении отклонена; пять Discovery-конфигураций подтверждены PUBACK.

Исправление 1.0.0: отметка поступления MQTT и вычисление возраста очереди используют один источник времени ESPHome. Смешение Arduino millis и ESPHome millis давало ложный expired_command. После исправления вся серия повторена успешно.

## Home Assistant (0.6.0)

На странице `/mqtt` есть отдельная галочка обнаружения HA. После подключения контроллер публикует пять retained Discovery-конфигураций с QoS1, последовательно ожидая PUBACK: climate, quiet, display, vertical_position, horizontal_position. При новом подключении и живом `homeassistant/status=online` цикл повторяется. `/mqtt/config.discovery_sent` показывает число подтверждённых конфигураций (0..5).

Discovery включён по умолчанию, MQTT по-прежнему выключен. Старые настройки NVS сохраняются: использован бывший нулевой резервный байт. Выключение Discovery останавливает публикацию конфигураций, но не удаляет уже сохранённые сущности у брокера/HA.

Климат HA использует `hvac_mode`: OFF выключает, остальные значения атомарно выбирают режим и включают питание. FAN_ONLY также задаёт LOW, поскольку AUTO вентилятора недопустим в этом режиме. Старый топик `mode` сохраняет независимость от питания. Обычный `power=ON` сохраняет ранее выбранный режим.

В список Discovery presets входят только boost/sleep; none добавляет HA. Для отсутствующего режима/вентилятора/качания шаблоны возвращают `None`. Quiet/display имеют optimistic-индикацию HA; фактическое состояние приходит с контроллера после завершения команды. Остальные сущности не optimistic. Устаревшие state в собственной очереди работника отбрасываются по поколению команды; уже отправленные по сети сообщения отозвать невозможно.

Проверены JSON, шаблоны Jinja, атомарное преобразование команд и доставка всех пяти Discovery с PUBACK от отдельного брокера. Интерфейс Home Assistant с этой S3 отдельно не проверялся; проверка брокера не заменяет UI-проверку HA.

На 1.0.0 дополнительно проверено восстановление MQTT после диагностического разрыва Wi-Fi без перезапуска ESP и повторная доставка пяти Discovery. Парольная аутентификация самого брокера и принудительный перезапуск брокера отдельно в этой серии не испытывались.
