dk-1983/Haier-ESP32-Modbus/docs/assets/haier-uart-optical-original.jpeg

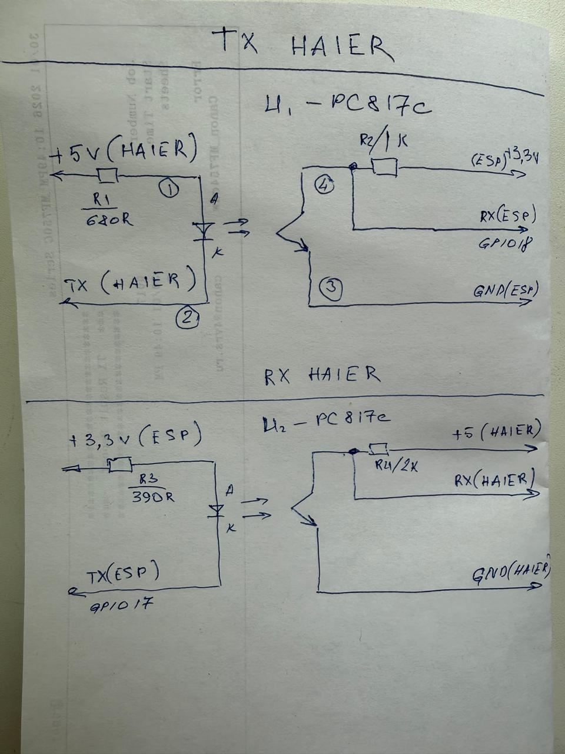
docs/assets/haier-uart-optical-original.jpeg
