dk-1983/Haier-ESP32-Modbus/docs/assets/haier-wifi-connector-photo-7.jpeg

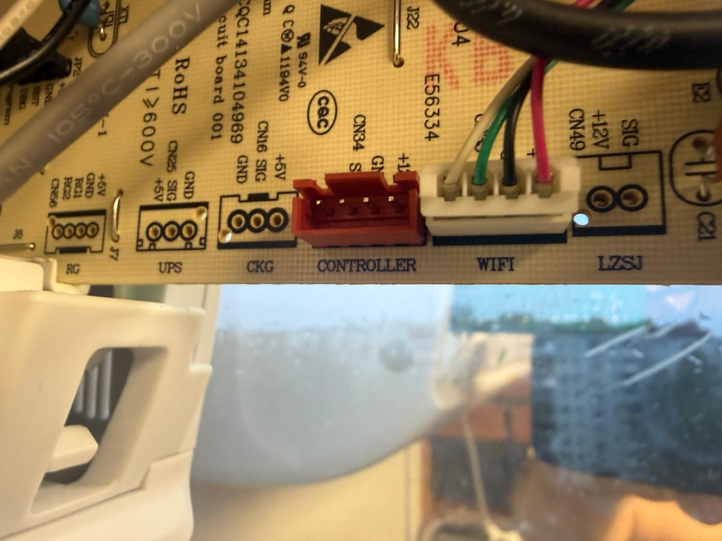
docs/assets/haier-wifi-connector-photo-7.jpeg
