dk-1983/Haier-ESP32-Modbus/docs/VALIDATION-1.2.0_RU.md

[English](VALIDATION-1.2.0.md) | [Русский](VALIDATION-1.2.0_RU.md)

# Приёмка v1.2.0 — 27.09.2026

Установка: ESP32-S3-WROOM-1 N16R8 и Haier AS25HSL1HRA-W; UART штатного Wi-Fi подключён через ESP. Кондиционер серверной оставался включённым в режиме COOL.

## Публичный бинарник

Чистая сборка GitHub Actions [36295257669](https://github.com/dk-1983/Haier-ESP32-Modbus/actions/runs/36295257669), коммит исходников прошивки `9974607026cc72d878e1b9bd8234711c74f0a7ae`. Последующие коммиты релиза меняют только документацию и подписанный манифест.

- MD5 OTA: `3b533cb0e3097f35e4ca229ef9ce0e7c`.
- SHA-256 OTA: `35b04fdbd933ee448b77a45f034acfdde858377d06cf7da5eb15b3a31418650a`.
- Контрольные суммы factory/OTA и инструкций совпали с CI. Подпись манифеста проверена открытым ключом, встроенным в прошивку; профиль — `haier-s3-n16r8-v2`.
- Именно этот публичный OTA-бинарник установлен через ArduinoOTA. Сохранились сеть, пароли, настройки MQTT/Modbus и охлаждения; после загрузки вернулись обмен со штатным модулем и актуальное состояние кондиционера.

## Команды и восстановление

При первой HTTP-проверке рабочая MQTT-автоматика сменила идентификатор запроса своей командой. Попытка остановлена, настройки восстановлены. Последующая последовательность выполнялась через временный тестовый MQTT-брокер, чтобы исключить конкурирующие команды автоматики.

- Прошли MQTT Discovery, получение состояния, отклонение retained-команд и недопустимой температуры. Семнадцать допустимых команд: уставки 21/22 °C, вентилятор HIGH/AUTO, вертикальное качание/OFF, BOOST/NONE, тихий режим и дисплей ON/OFF, положения жалюзи и power ON.
- Шестнадцать HTTP-команд проверили те же функции, кроме питания; каждая подтверждена двумя сообщениями состояния и сравнением с запрошенным значением.
- Modbus TCP: чтение FC01/03/04, запись FC05/06/15/16, корректные ответы и подтверждения команд кондиционером. Недопустимые значение, адрес и функция дали ожидаемые исключения. Это проверка TCP-сервера и команд через UART, а не физического трансивера RS-485.
- При окончательном восстановлении: с загрузки получено 549 пакетов основной платы и 464 штатного модуля, 86 наших запросов/86 ответов, восстановлены 4 преамбулы. Необработанных ошибок разбора, таймаутов неполных кадров/транзакций и переполнений нет.
- Рабочий MQTT возвращён и подключён; отброшенных сообщений и ошибки MQTT нет. Исходные флаги RTU/TCP восстановлены. Итог: **питание ON, COOL, 22 °C, LOW, качание OFF, preset NONE, quiet OFF, дисплей ON, оба положения CENTER**.

## Предыдущие аппаратные проверки и ограничения

Образ разработки с той же реализацией моста прошёл [30-минутный прогон и физическое отключение/возвращение штатного модуля](UART_BRIDGE_RU.md#актуальные-аппаратные-результаты--27092026). Это отдельные проверки: второй 30-минутный прогон публичного бинарника не заявляется.

Физический RS-485 на GPIO8/9 отложен до получения платы MAX485. Выключение питания, нагрев и осушение в этой проверке публичного образа не выполнялись: кондиционер охлаждает серверное оборудование. Проверки этой установки не подтверждают все модели Haier, заводские функции и процедуры заводского OTA.

Первое обновление с v1.1.0 выполняется вручную после [проверки новой распиновки](FLASHING_RU.md). Заказанная PCB rev1.0 использует прежние выводы RS-485; её разводка и Gerber не менялись и не публикуются.
