dk-1983/Haier-ESP32-Modbus/docs/VALIDATION_RU.md

[English](VALIDATION.md) | [Русский](VALIDATION_RU.md)

# Проверки 1.0.0

Целевая платформа: ESP32-S3-WROOM-1 N16R8. Кондиционер: Haier AS25HSL1HRA-W. Дата испытаний: 2026-09-21. Перед релизом команды проверялись на 0.6.8; 1.0.0 также исправляет единый источник времени MQTT; после установки MQTT-серия повторена полностью и успешно.

## Программные проверки

- `python tools/test_host.py`: преобразование MQTT/Modbus в поля hOn, атомарность записи, FC01/03/04/05/06/15/16, исключения, RTU CRC/broadcast, MBAP/фрагментация, 50 000 некорректных PDU и защита границ буферов.
- Проверка `status_sensors.h`: защитные байты вокруг структуры, null, укороченные и расширенные пакеты. Четыре дополнительных байта ответа больше не перезаписывают соседние объекты.
- `python tests/test_discovery.py`: пять JSON Discovery, шаблоны Jinja, отсутствие `none` в передаваемом списке presets, пустые значения и ограничение размера пакета.
- `python tools/test_hon_simulator.py`: 2000 обменов с кодеком установленного HaierProtocol, CRC, испорченные кадры, восстановление и тайм-ауты.
- Сборка ESPHome 2026.6.5 / Arduino-ESP32 3.3.9 для 16 МБ Flash и 8 МБ PSRAM: SUCCESS.

## Реальный Haier: HTTP и Modbus TCP

Каждая принятая команда подтверждалась двумя новыми совпадающими status-пакетами. HTTP202 или Modbus echo отдельно успехом не считались. Исходная конфигурация сохранена перед тестами и восстановлена после серии.

| Функция | Проверено |
|---|---|
| Уставка | изменение, возврат; границы 16/30 при выключенном блоке |
| Вентилятор | LOW / MEDIUM / HIGH / AUTO |
| Жалюзи | OFF / VERTICAL / HORIZONTAL / BOTH |
| Вертикальные положения | HEALTH_UP / MAX_UP / HEALTH_DOWN / UP / CENTER / DOWN |
| Горизонтальные положения | MAX_LEFT / LEFT / CENTER / RIGHT / MAX_RIGHT |
| Пресеты | BOOST / SLEEP / NONE |
| Quiet, дисплей | ON / OFF |
| Питание | OFF, пауза не менее 180 секунд, ON; возврат COOL |
| Режимы | запись COOL / HEAT / DRY / FAN_ONLY / AUTO при выключенном блоке |
| Блокировка | LOCK / UNLOCK и нормализация кодов 2/3; подтверждение бита hOn |
| Modbus чтение | FC01, FC03, FC04 |
| Modbus запись | FC05, FC06, FC15, FC16 с подтверждением hOn |
| Ошибки | недопустимая уставка, адрес, неподдерживаемая функция отклонены |

Режимы проверялись без запуска нагрева серверной. Это проверка записи и обратного чтения режима, не испытание тепловой производительности каждого режима. Подтверждение lock-бита не заменяет проверку поведения физического ИК-пульта.

## Стенд электрических интерфейсов

- UART GPIO17/18: петля PASS, снятие перемычки FAIL, восстановление контакта PASS, 9600 8N1.
- Эмулятор Haier на Arduino Nano ATmega328P: обмен и команды питания/уставки/вентилятора.
- RS-485: MAX485, GPIO15 DI, GPIO16 RO через согласование уровня, GPIO21 DE+/RE. Чтение через [4VRS Gateway для Moxa](https://github.com/dk-1983/moxa-4vrs-gateway) (UC-7420-LX Plus, Modbus TCP → RTU) и [Modbus Devices для Home Assistant](https://github.com/dk-1983/Modbus_Devices) с профилем YCJ-A002 при 19200 8N1 подтверждено.
- Оптопары общего назначения создавали затянутые фронты; на DI MAX485 прямое управление устранило искажения. Резистивное согласование RO проверено осциллографом.
- После удаления стенда RS-485 физические RTU-записи на реальном кондиционере не повторялись. Программное ядро общее с TCP, однако это не отдельное аппаратное доказательство RTU-записи.

## Границы проверки

Не заявляются: нулевая вероятность ошибок, совместимость со всеми Haier, соответствие ненулевых fault-кодов YCJ-A002, промышленная электромагнитная устойчивость, законченная гальваническая развязка и длительный ресурсный прогон. Принудительный обрыв проводов кондиционера и сброс Wi-Fi в рабочей серверной в эту серию не входят. Устройства ESP8266 отдельно ранее испытаны, но их результаты не подменяют тесты S3.

Сырые логи, адреса стенда, пароли и образы с индивидуальными паролями не входят в публичный релиз.

## Повторяемая проверка HTTP

`python tools/hil_controls.py --url http://DEVICE_IP --mac EXPECTED_MAC --log work/hil.jsonl --execute`

Пароль вводится интерактивно. Скрипт требует включённое охлаждение, сохраняет исходное состояние, проверяет команды последовательно и восстанавливает настройки даже при ошибке. При неудачном восстановлении возвращает ошибку. Это реальное управление кондиционером, а не симуляция; запускать только при подходящих условиях эксплуатации. Лог хранить локально.

## MQTT и OTA на 1.0.0

- 41 MQTT-команда подтверждена реальным Haier, включая OFF/ON и все доступные группы настроек. Пять Discovery получили PUBACK; retained-команда при подписке отклонена без изменения уставки.
- При первом прогоне 0.6.8 обнаружен ложный expired_command: приёмник использовал Arduino millis, основной цикл — ESPHome millis. В 1.0.0 обе стороны используют ESPHome millis. Полный повтор прошёл без этой ошибки.
- Полный образ 1.0.0 передан ArduinoOTA; после перезапуска проверены версия, совпадение MD5 с локальным образом, сохранение Wi-Fi, 8 МБ PSRAM и восстановление свежих hOn-пакетов.
- Проверка MQTT выполнена с отдельным тестовым брокером. Реальный интерфейс Home Assistant для этой S3 не включён в серию.

## Восстановление и защита API на 1.0.0

Авторизация HTTP401, неверный токен403, неверное значение400, повторный request_id без повторной команды и конфликтующая запись409 проверены на устройстве. Основные веб-страницы отвечают200. После диагностического разрыва Wi-Fi контроллер восстановил сеть и MQTT, повторил пять Discovery с PUBACK; uptime продолжился, новые status-пакеты Haier поступали. Настройки MQTT/Modbus после тестов возвращены к исходным выключенным транспортам; кондиционер оставлен включённым в COOL, 22 °C, AUTO, NONE, Quiet OFF, дисплей ON, жалюзи OFF/CENTER.

## Системы, использованные в проверках

- **[Modbus Devices для Home Assistant](https://github.com/dk-1983/Modbus_Devices)** — клиентская интеграция Home Assistant, профиль YCJ-A002 для опроса базовых параметров шлюза.
- **[Moxa / 4VRS Gateway](https://github.com/dk-1983/moxa-4vrs-gateway)** — шлюз на UC-7420-LX Plus, связывающий сетевой клиент с физической линией RS-485 ESP.

Проверяемый тракт: **Home Assistant / Modbus Devices → Moxa / 4VRS Gateway → RS-485 / MAX485 → ESP32-S3**. Для описанной проверки Moxa использовала Modbus TCP → RTU, последовательная линия — 19200 8N1. Чтение через этот тракт подтверждено; границы проверки записи указаны в разделе стенда выше. Выбор транспорта описан в [REGISTERS.md](REGISTERS_RU.md#home-assistant-и-moxa).
