dk-1983/Haier-ESP32-Modbus/CHANGELOG_RU.md

[English](CHANGELOG.md) | [Русский](CHANGELOG_RU.md)

# 1.2.0 — 2026-09-27

- Новый профиль подписанных обновлений v2 исключает автоматический переход с распиновки v1.1.0; первое обновление выполняется вручную после проверки монтажа GPIO15/16.

- Прозрачный UART-мост штатного Wi-Fi: сохранены TX17/RX18 основной платы, добавлены RX15/TX16 штатного модуля; автоматический самостоятельный опрос и возврат моста.
- Modbus перенесён на RX8/TX9; направление GPIO21 и карта регистров сохранены. Монтаж RS-485 платы rev1.0 требует адаптации.
- Ограниченное восстановление отсутствующего/лишнего разделителя основной платы с проверками суммы и CRC; диагностика UART и регрессионные тесты.
- Совместная работа и отключение/возвращение модуля проверены аппаратно: [UART_BRIDGE_RU.md](docs/UART_BRIDGE_RU.md). RS-485 на новых выводах пока не проверен.
- Двуязычные схема моста и README с акцентом на сохранение штатного управления, Modbus Devices и MQTT. Публичные factory/OTA-бинарники собраны в чистом CI и проверены на работающем контроллере Haier: [приёмка публичного образа](docs/VALIDATION-1.2.0_RU.md).

# 1.1.0 — 2026-09-22

- Личные пароли web, ArduinoOTA и точки настройки в NVS; защищённая страница `/settings`. Пароли сохраняются при обновлении и сбросе Wi-Fi.
- Публичная прошивка при первом запуске требует задать личные пароли до включения сетевого управления. Приватная миграция сохраняет прежние реквизиты.
- Подписанные обновления GitHub stable: HTTPS, ECDSA P-256, SHA-256, проверка платы и заголовка приложения, запись в неактивный раздел и сохранение разрешения автообновления на `/updates`.
- Ручная проверка/установка, прогресс и ошибки, исключение одновременной записи ArduinoOTA/GitHub, запрет повторов неудачного образа и программный пробный запуск/возврат.
- Готовые factory/OTA-образы и двуязычная инструкция. См. [управление и ограничения](docs/MANAGEMENT_RU.md).

# 1.0.0 — 2026-09-21

- Исправлен единый источник времени MQTT: отметка получения и проверка возраста используют ESPHome millis, предотвращая ложный expired_command.
- Первый стабильный выпуск ESP32-S3 N16R8: локальный веб-пульт, MQTT/Discovery, независимые Modbus RTU и TCP, ArduinoOTA.
- Аппаратные проверки команд по ответам реального Haier; проверка RS-485 на стенде с эмулятором.
- Включены исправления границ копирования hOn (0.6.7) и обслуживания watchdog при OTA (0.6.8).
- Обновлены подключение, результаты испытаний и ограничения. Исходники без индивидуальных паролей и образов устройства.

# 0.6.8 — 2026-09-21

- Во время синхронной ArduinoOTA-загрузки обслуживается watchdog ESPHome по событиям начала и прогресса передачи. Watchdog остаётся включённым.
- Исправляет подтверждённую перезагрузку loopTask во время передачи полного образа по Wi-Fi.

# 0.6.7 — 2026-09-21

- Исправлена запись за границей 18-байтной структуры датчиков при приёме hOn: четыре дополнительных байта протокола больше не перезаписывают соседние поля веб-сервера.
- Добавлена проверка границ копирования с защитными байтами и укороченными пакетами.
- Номера 0.6.1–0.6.6 использовались для отдельных аппаратных диагностических сборок.

# 0.6.0 — 2026-09-20

- Паритет веб-пульта с ESP8266 v0.5.1: питание, разделы управления, общее меню, обзор, Wi-Fi и информация о памяти/PSRAM.
- Home Assistant Discovery пяти сущностей с QoS1/PUBACK; отдельный выключатель.
- Атомарный HVAC mode+power, подавление промежуточной телеметрии и отбрасывание старого state в очереди.
- Таблица сообщений hOn хранится без динамических строк. Сохранены Modbus и существующая раскладка NVS.
- Программная проверка и сборка; испытания на S3 ожидают готовности аппаратной части.

# Изменения

## 0.5.1 — 2026-09-20

- Защищённая страница `/wifi/reset`: очистка сохранённой и ожидающей сети с возвратом setup AP.
- Сохранение настроек MQTT/Modbus и паролей управления при сбросе сети.
- Сброс выполняется после HTTP-ответа; во время команды кондиционера или настройки сети возвращается busy.

## 0.5.0 — 2026-09-20

- MQTT-клиент внешнего брокера через Wi-Fi на ESP-MQTT.
- Отдельный выключатель и настройки брокера на `/mqtt`, сохранение в NVS без выдачи пароля через API.
- Топики состояния, доступности/Last Will, команд и результатов; общий арбитр с HTTP/Modbus.
- Фоновые сетевые операции, ограниченные очереди, отклонение retained-команд при подписке.
- Тесты преобразования команд и фрагментации сообщений, документация MQTT.

## 0.4.0 — 2026-09-20

- Перенос проверенного ESP8266 PoC на ESP32-S3-WROOM-1 N16R8.
- Карта YCJ-A002 и расширения, независимые Modbus RTU и TCP.
- Веб-пульт, Wi-Fi setup и OTA, исходные документы и native-тесты.
- Локальный коммит 0e3f371; версия в health исторически называлась `0.4.0-s3-modbus`.

Версия прошивки задаётся в components/fourvrs_portal/version.h и видна в `/health`. Git-теги vX.Y.Z отмечают исходники соответствующей версии. Сборка/тесты на ПК и проверка на оборудовании отмечаются раздельно; тег не означает аппаратную сертификацию.

## 0.6.1 — отменённая диагностическая сборка

- Пробная сборка с подтяжкой RX собрана, но не установлена: OTA прервалась. По решению пользователя эксперимент отменён; исходники UART и версия возвращены к v0.6.0 без подтяжек. Не использовать пробный образ 0.6.1.

## 0.6.2-tx-invert — диагностическая сборка

- По запросу пользователя инвертирован только Haier TX GPIO17. RX GPIO18 без инверсии, обе подтяжки выключены. Предназначена для измерения выхода, не подтверждена как рабочая конфигурация Haier. Сборка прошла, OTA прервалась; установка не подтверждена.
