dk-1983/Haier-ESP32-Modbus/components/haier/haier_base.h

#pragma once

#include <chrono>
#include "inline_bridge.h"
#include "esphome/components/climate/climate.h"
#include "esphome/components/uart/uart.h"
#include "esphome/core/automation.h"
// HaierProtocol
#include <protocol/haier_protocol.h>

#ifdef USE_SWITCH
#include "esphome/components/switch/switch.h"
#endif

namespace esphome::haier {

enum class ActionRequest : uint8_t {
  SEND_CUSTOM_COMMAND = 0,
  TURN_POWER_ON = 1,
  TURN_POWER_OFF = 2,
  TOGGLE_POWER = 3,
  START_SELF_CLEAN = 4,   // only hOn
  START_STERI_CLEAN = 5,  // only hOn
};

struct HaierBaseSettings {
  bool health_mode;
  bool display_state;
};

class HaierClimateBase : public esphome::Component,
                         public esphome::climate::Climate,
                         public esphome::uart::UARTDevice,
                         public haier_protocol::ProtocolStream,
                         protected haier_inline::Sink {
#ifdef USE_SWITCH
 public:
  void set_display_switch(switch_::Switch *sw);
  void set_health_mode_switch(switch_::Switch *sw);

 protected:
  switch_::Switch *display_switch_{nullptr};
  switch_::Switch *health_mode_switch_{nullptr};
#endif
 public:
  HaierClimateBase();
  HaierClimateBase(const HaierClimateBase &) = delete;
  HaierClimateBase &operator=(const HaierClimateBase &) = delete;
  ~HaierClimateBase();
  void setup() override;
  void loop() override;
  void control(const esphome::climate::ClimateCall &call) override;
  void dump_config() override;
  float get_setup_priority() const override { return esphome::setup_priority::HARDWARE; }
  void set_display_state(bool state);
  bool get_display_state() const;
  void set_health_mode(bool state);
  bool get_health_mode() const;
  void send_power_on_command();
  void send_power_off_command();
  void toggle_power();
  void reset_protocol() { this->reset_protocol_request_ = true; };
  void set_supported_modes(esphome::climate::ClimateModeMask modes);
  void set_supported_swing_modes(esphome::climate::ClimateSwingModeMask modes);
  void set_supported_presets(esphome::climate::ClimatePresetMask presets);
  bool valid_connection() const { return this->protocol_phase_ >= ProtocolPhases::IDLE; };
  void set_factory_uart(uart::UARTComponent *value) { factory_uart_ = value; }
  const haier_inline::Bridge *inline_bridge() const { return inline_bridge_.get(); }
  size_t available() noexcept override;
  size_t read_array(uint8_t *data, size_t len) noexcept override;
  void write_array(const uint8_t *data, size_t len) noexcept override;
  bool can_send_message() const { return haier_protocol_.get_outgoing_queue_size() == 0; };
  void set_answer_timeout(uint32_t timeout);
  void set_send_wifi(bool send_wifi);
  void send_custom_command(const haier_protocol::HaierMessage &message);
  template<typename F> void add_status_message_callback(F &&callback) {
    this->status_message_callback_.add(std::forward<F>(callback));
  }

 protected:
  uart::UARTComponent *factory_uart_{nullptr};
  std::unique_ptr<haier_inline::Bridge> inline_bridge_;
  uint8_t local_rx_[2048]{};
  size_t local_head_{0}, local_size_{0};
  void pump_bridge_();
  void to_main(const uint8_t *data, size_t len) override { UARTDevice::write_array(data, len); }
  void to_factory(const uint8_t *data, size_t len) override { factory_uart_->write_array(data, len); }
  void to_local(const uint8_t *data, size_t len) override;
  void observe(const haier_inline::Frame &frame) override {}
  enum class ProtocolPhases {
    UNKNOWN = -1,
    // INITIALIZATION
    SENDING_INIT_1 = 0,
    SENDING_INIT_2,
    SENDING_FIRST_STATUS_REQUEST,
    SENDING_FIRST_ALARM_STATUS_REQUEST,
    // FUNCTIONAL STATE
    IDLE,
    SENDING_STATUS_REQUEST,
    SENDING_UPDATE_SIGNAL_REQUEST,
    SENDING_SIGNAL_LEVEL,
    SENDING_CONTROL,
    SENDING_ACTION_COMMAND,
    SENDING_ALARM_STATUS_REQUEST,
    NUM_PROTOCOL_PHASES
  };
  const char *phase_to_string_(ProtocolPhases phase);
  virtual void set_handlers() = 0;
  virtual void process_phase(std::chrono::steady_clock::time_point now) = 0;
  virtual haier_protocol::HaierMessage get_control_message() = 0;          // NOLINT(readability-identifier-naming)
  virtual haier_protocol::HaierMessage get_power_message(bool state) = 0;  // NOLINT(readability-identifier-naming)
  virtual void save_settings();
  virtual void initialization();
  virtual bool prepare_pending_action();
  virtual void process_protocol_reset();
  esphome::climate::ClimateTraits traits() override;
  // Answer handlers
  haier_protocol::HandlerError answer_preprocess_(haier_protocol::FrameType request_message_type,
                                                  haier_protocol::FrameType expected_request_message_type,
                                                  haier_protocol::FrameType answer_message_type,
                                                  haier_protocol::FrameType expected_answer_message_type,
                                                  ProtocolPhases expected_phase);
  haier_protocol::HandlerError report_network_status_answer_handler_(haier_protocol::FrameType request_type,
                                                                     haier_protocol::FrameType message_type,
                                                                     const uint8_t *data, size_t data_size);
  // Timeout handler
  haier_protocol::HandlerError timeout_default_handler_(haier_protocol::FrameType request_type);
  // Helper functions
  void send_message_(const haier_protocol::HaierMessage &command, bool use_crc, uint8_t num_repeats = 0,
                     std::chrono::milliseconds interval = std::chrono::milliseconds::zero());
  virtual void set_phase(ProtocolPhases phase);
  void reset_phase_();
  void reset_to_idle_();
  bool is_message_interval_exceeded_(std::chrono::steady_clock::time_point now);
  bool is_status_request_interval_exceeded_(std::chrono::steady_clock::time_point now);
  bool is_control_message_interval_exceeded_(std::chrono::steady_clock::time_point now);
  bool is_protocol_initialisation_interval_exceeded_(std::chrono::steady_clock::time_point now);
#ifdef USE_WIFI
  haier_protocol::HaierMessage get_wifi_signal_message_();
#endif

  struct HvacSettings {
    esphome::optional<esphome::climate::ClimateMode> mode;
    esphome::optional<esphome::climate::ClimateFanMode> fan_mode;
    esphome::optional<esphome::climate::ClimateSwingMode> swing_mode;
    esphome::optional<float> target_temperature;
    esphome::optional<esphome::climate::ClimatePreset> preset;
    bool valid;
    HvacSettings() : valid(false){};
    HvacSettings(const HvacSettings &) = default;
    HvacSettings &operator=(const HvacSettings &) = default;
    void reset();
  };
  struct PendingAction {
    ActionRequest action;
    esphome::optional<haier_protocol::HaierMessage> message;
  };
  enum class SwitchState {
    OFF = 0b00,
    ON = 0b01,
    PENDING_OFF = 0b10,
    PENDING_ON = 0b11,
  };
  haier_protocol::ProtocolHandler haier_protocol_;
  ProtocolPhases protocol_phase_;
  esphome::optional<PendingAction> action_request_;
  uint8_t fan_mode_speed_;
  uint8_t other_modes_fan_speed_;
  SwitchState display_status_{SwitchState::ON};
  SwitchState health_mode_{SwitchState::OFF};
  bool force_send_control_;
  bool forced_request_status_;
  bool reset_protocol_request_;
  bool send_wifi_signal_;
  bool use_crc_;
  esphome::climate::ClimateTraits traits_;
  HvacSettings current_hvac_settings_;
  HvacSettings next_hvac_settings_;
  std::unique_ptr<uint8_t[]> last_status_message_{nullptr};
  std::chrono::steady_clock::time_point last_request_timestamp_;       // For interval between messages
  std::chrono::steady_clock::time_point last_valid_status_timestamp_;  // For protocol timeout
  std::chrono::steady_clock::time_point last_status_request_;          // To request AC status
  std::chrono::steady_clock::time_point last_signal_request_;          // To send WiFI signal level
  CallbackManager<void(const char *, size_t)> status_message_callback_{};
  ESPPreferenceObject base_rtc_;
};

}  // namespace esphome::haier
