dk-1983/Haier-ESP32-Modbus/(commit log)

2026-09-19 Port Haier bridge to ESP32-S3 with YCJ-A002 Modbus RTU and TCP
    [registers.csv]
2026-09-19 feat(mqtt): add configurable asynchronous Wi-Fi broker client
    [test_modbus.cpp]
2026-09-20 docs(hardware): preserve agreed S3 wiring for schematic design
2026-09-20 fix(uart): prepare S3 RX pull-up diagnostic build
    [haier-s3.yaml]
2026-09-20 revert(uart): cancel RX pull-up experiment at user request
    [haier-s3.yaml]
2026-09-20 test(uart): prepare TX inversion build for pin measurement
2026-09-20 fix(uart): restore normal UART after successful GPIO bench tests
    [haier-s3.yaml]
2026-09-20 test(uart): add hardware loopback with production UART configuration
2026-09-20 docs(test): record successful S3 hardware UART loopback
2026-09-20 docs(test): confirm UART loopback recovery after contact correction
2026-09-20 docs(hardware): propose two-channel PC817 UART bench interface
2026-09-20 feat(bench): add Nano hOn appliance simulator for optical UART tests
2026-09-20 feat(bench): expose raw UART bytes for optical link diagnosis
2026-09-20 fix: bound hOn sensor copy to prevent portal memory corruption
    [test_host.py, test_status_sensors.cpp]
2026-09-20 fix: feed ESPHome task watchdog during Arduino OTA transfer
2026-09-21 fix: include size definition in standalone hOn packet header
    [hon_packet.h]
2026-09-21 docs: link Modbus Devices and Moxa used in bench validation
2026-09-21 docs: add verified ESP32-S3 and MAX485 schematic
2026-09-21 docs: highlight ready Home Assistant integration via Modbus Devices
2026-09-21 docs: describe MQTT assembly without optional RS485 hardware
2026-09-21 Illustrate Haier Wi-Fi connector and document confirmed TX RX wire mapping
2026-09-21 Document confirmed Haier connector power wire polarity
2026-09-21 Credit haier-esphome foundation and distinguish connector ordering references
2026-09-22 Document optional optical UART circuit and measured bench limitations
2026-09-22 Add combined room sensors and Haier thermostat card example
2026-09-23 docs: publish rev1.0 electrical schematic without PCB manufacturing files
2026-09-27 Add Haier factory UART bridge and prepare v1.2.0 public build
2026-09-27 Show current UART bridge schematic in both READMEs
2026-09-27 Document v1.2.0 public firmware acceptance and release wiring
2026-09-27 Publish signed v1.2.0 update manifest for v2 wiring profile
2026-10-08 Fix UART reply quarantine and add logged recovery for v1.3.1
    [inline_bridge.h]
2026-10-09 Fix MQTT select unknown positions for v1.3.2
    [test_discovery.py]
